verdanatesman/Boost-Converter-Tasarimi-ve-Uretimi-/README.md

# Boost-Converter-Tasarimi-ve-Uretimi-
4.Sınıfta tasarım derdi için KiCad üzerinden Boost Converter devresi tasarımı ve üretim süreçleri raporlarda ve görsellerde görülebilir.
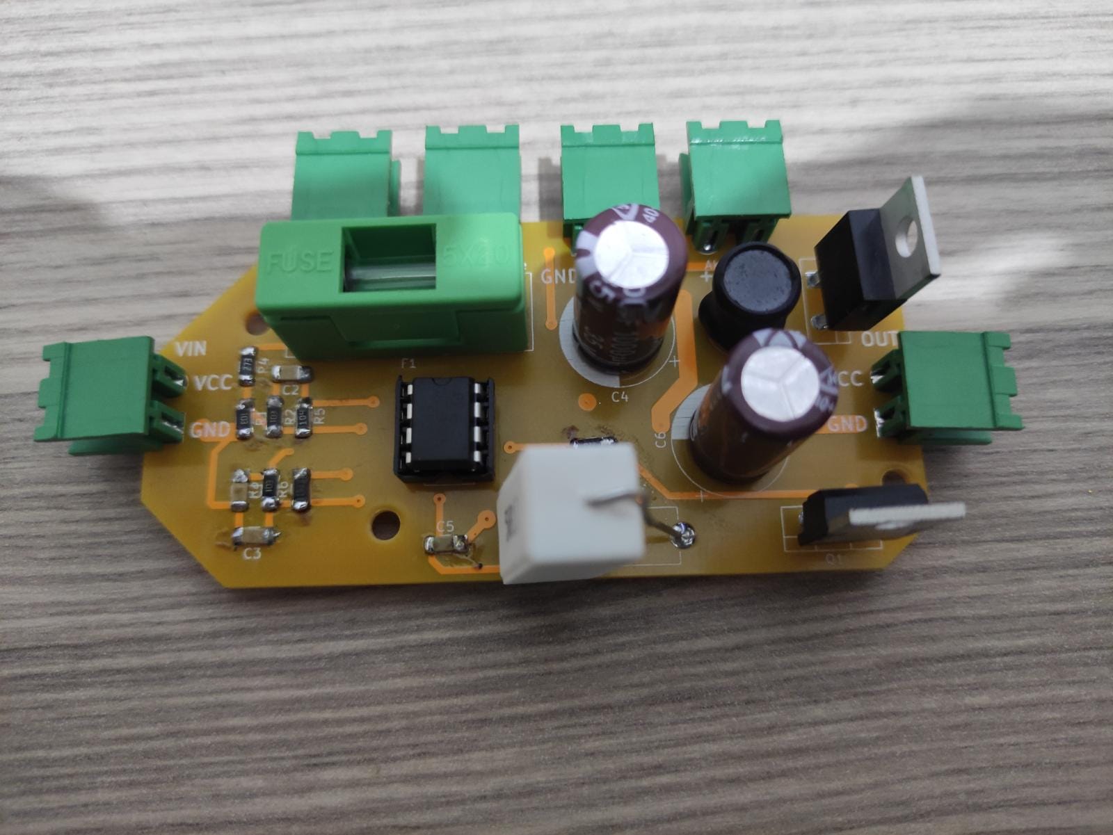
[picture p1: kart üst.jpeg]
resim
