verdanatesman/Boost-Converter-Tasarimi-ve-Uretimi-/kart alt.jpeg

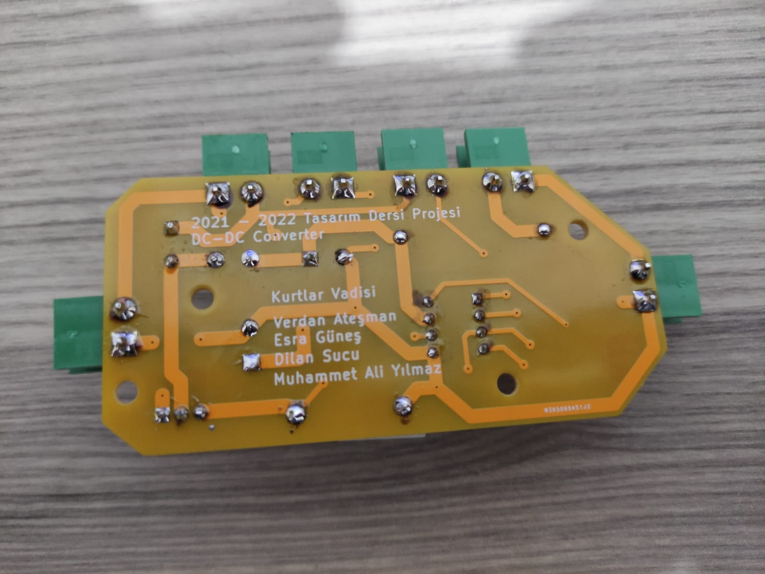
kart alt.jpeg
