verdanatesman/Boost-Converter-Tasarimi-ve-Uretimi-/kutu son hali.jpeg

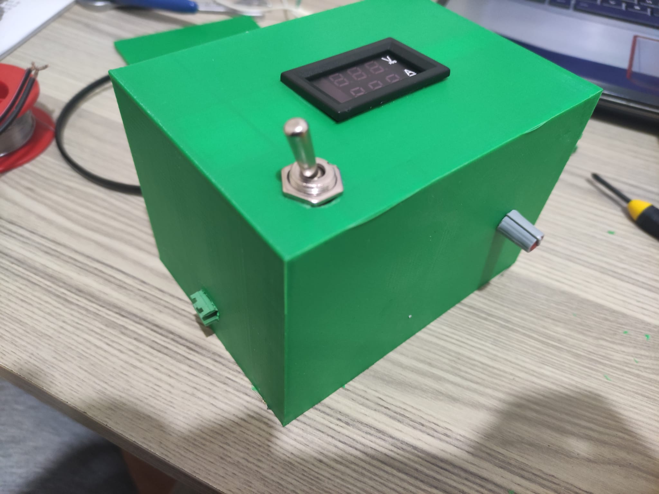
kutu son hali.jpeg
