verdanatesman/Boost-Converter-Tasarimi-ve-Uretimi-/kutu son halii.jpeg

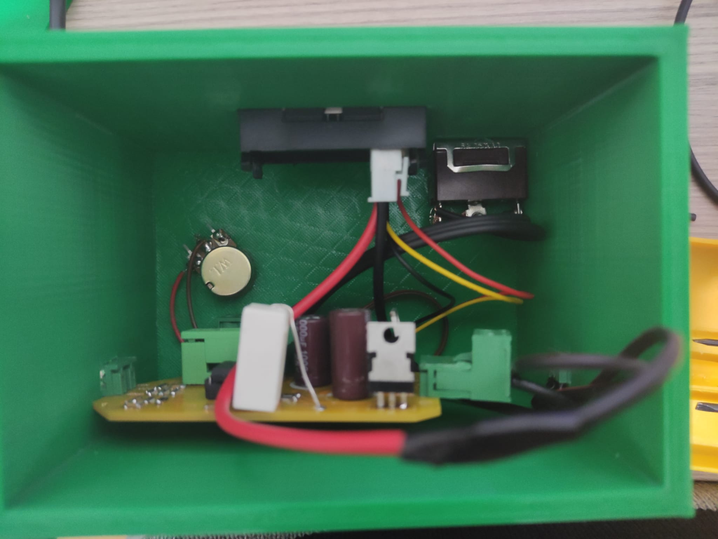
kutu son halii.jpeg
