verdanatesman/Boost-Converter-Tasarimi-ve-Uretimi-/pcb arka gerçek.jpeg

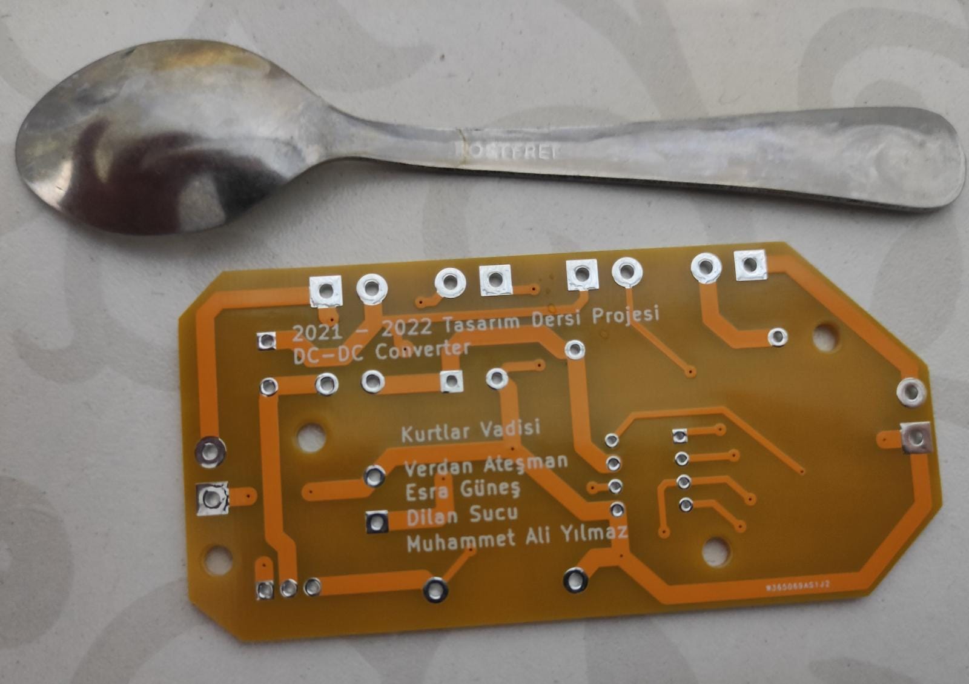
pcb arka gerçek.jpeg
