verdanatesman/Boost-Converter-Tasarimi-ve-Uretimi-/pcb ön gerçek.jpeg

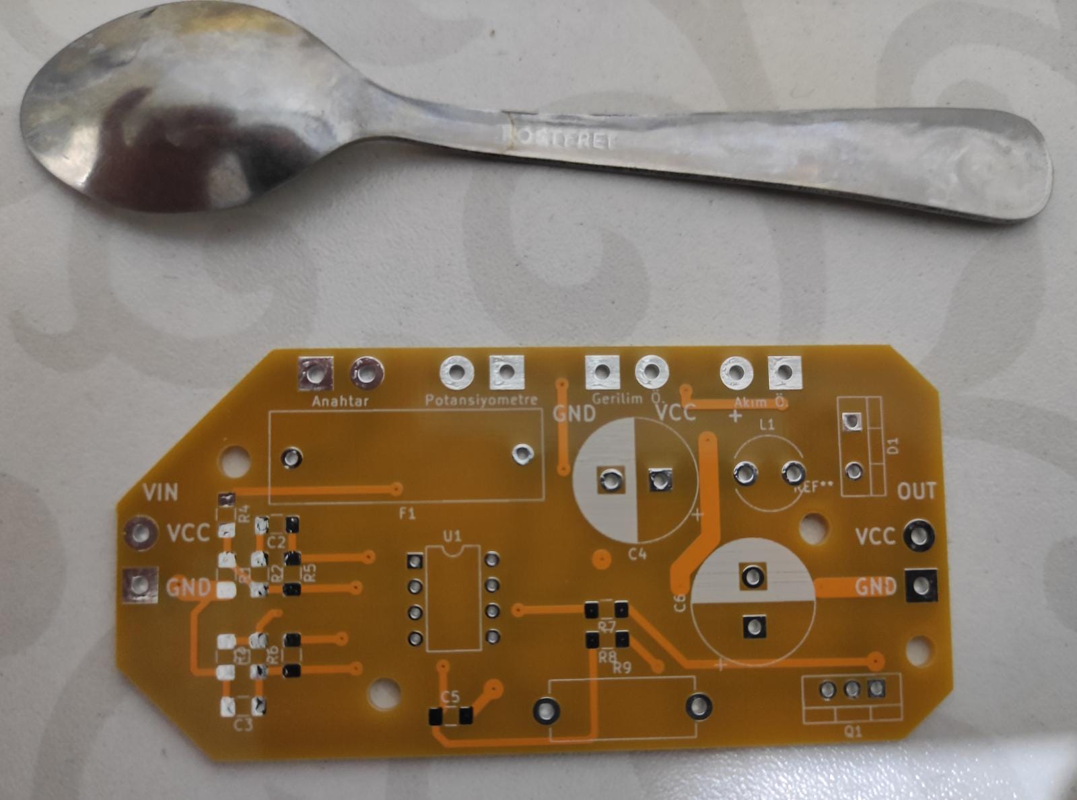
pcb ön gerçek.jpeg
