verdanatesman/Boost-Converter-Tasarimi-ve-Uretimi-/KiCad/tasarim/tasarim.kicad_pcb

## KiCad design KiCad/tasarim/tasarim.kicad_pcb (2023-02-11)

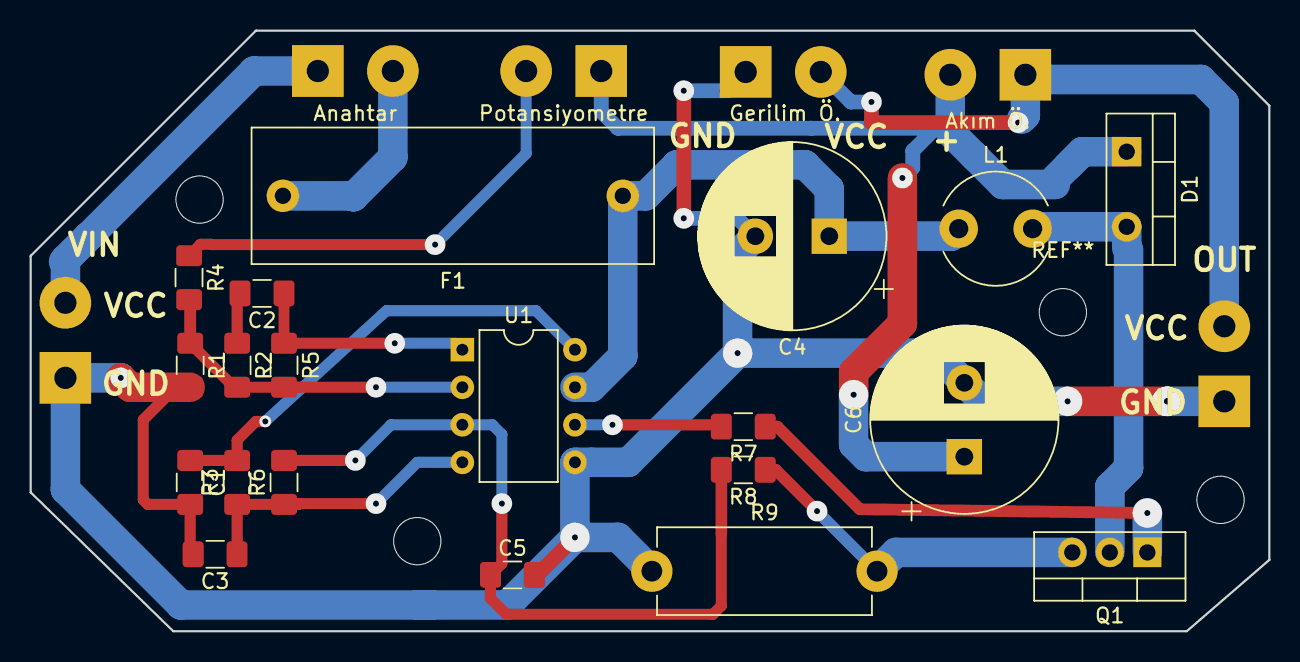
[picture p14: board tasarim.kicad_pcb from above]

Board: 2 copper layers, 83.8 x 40.6 mm, 23 parts (0 on the bottom side), 15 nets.

Parts:
Akım Ö.: Akım Ö.; SolderWirePad_1x02_P5.08mm_Drill1.5mm
C1, C2: 10nF; C_1206_3216Metric_Pad1.42x1.75mm_HandSolder
C3, C5: 1nF; C_1206_3216Metric_Pad1.42x1.75mm_HandSolder
C4, C6: 1000uF; CP_Radial_D12.5mm_P5.00mm
D1: BYW29; TO-220-2_Vertical
F1: 5A Sigorta; C_Rect_L27.0mm_W9.0mm_P23.00mm
Gerilim Ö.: Gerilim Ö.; SolderWirePad_1x02_P5.08mm_Drill1.5mm
L1: 20uh; L_Radial_D7.5mm_P5.00mm_Fastron_07P
Potansiyometre: 100K POT; SolderWirePad_1x02_P5.08mm_Drill1.5mm
Q1: BUZ11; TO-220-3_Vertical
R1, R2, R3: 10K; R_1206_3216Metric_Pad1.42x1.75mm_HandSolder
R4: 27K; R_1206_3216Metric_Pad1.42x1.75mm_HandSolder
R5: 100K; R_1206_3216Metric_Pad1.42x1.75mm_HandSolder
R6: 15K; R_1206_3216Metric_Pad1.42x1.75mm_HandSolder
R7: 22r; R_1206_3216Metric_Pad1.42x1.75mm_HandSolder
R8: 1K; R_1206_3216Metric_Pad1.42x1.75mm_HandSolder
R9: 0.1R 5W; R_Axial_DIN0614_L14.3mm_D5.7mm_P15.24mm_Horizontal
U1: UC3843_DIP8; DIP-8_W7.62mm

Connections:
GNDREF: C1.2, C3.2, C4.2, C5.2, C6.2, Gerilim Ö..1, R1.2, R9.1, U1.5
unnamed: C1.1, R3.2, U1.8
unnamed: C2.1, R5.1, U1.1
unnamed: C2.2, R2.1
unnamed: C3.1, R3.1, R6.1, U1.4
unnamed: C4.1, F1.1, L1.1, U1.7
unnamed: C5.1, R6.2, R8.2, U1.3
unnamed: Akım Ö..2, C6.1, D1.1, Potansiyometre.1
unnamed: D1.2, L1.2, Q1.2
unnamed: Potansiyometre.2, R4.1
unnamed: Akım Ö..1, Gerilim Ö..2
unnamed: Q1.1, R7.1
unnamed: Q1.3, R8.1, R9.2
unnamed: R1.1, R2.2, R4.2, R5.2, U1.2
unnamed: R7.2, U1.6
